smasimore/EnvironmentalControlSystem/Documentation/ECSBOM.xlsx

 | Component | Subsystem | Purpose | Quantity | PCB REF DES | PCB Package | Manufacturer | Mfg. P/N | Distributor | P/N | Unit Cost ($) | Cost ($) | Included in $40 Constraint | Where To Get | Datasheet
Electrical | Air Quality Click Sensor | Controller | CO2 Sensor | 1 | U4 | user | MikroElektronika | MIKROE-1630 | Digikey | 1471-1358-ND | 16.83 | 16.83 | TRUE | Order Online | http://download.mikroe.com/documents/add-on-boards/click/air-quality/air-quality-click-manual-v100.pdf
 | TM4C123GH6PM 64-pin LQFP | Controller | CPU | 1 | U1 | LQFP | TI | TM4C123GH6PMI | Mouser | 595-TM4C123GH6PMI | 11.55 | 11.55 | FALSE | PCB | http://www.ti.com/lit/ds/symlink/tm4c123gh6pm.pdf
 | 18-bit color 128*160 1.8" TFT LCD display | Controller | LCD | 1 | J4 | LCD | Sitronix | ST7735R | Adafruit | 358 | $19.96 | 19.96 | FALSE | Order Online | https://www.crystalfontz.com/controllers/ST7735/
 | 8-Ohm Speaker | Controller | Speaker | 1 | J2 | DIP | PUI Audio | AS03208MS-3-R | Mouser | 665-AS03208MS-3-R | 8.97 | 8.97 | FALSE | Cabinet
 | Power Header | Controller | Power | 1 | J8 | SIP |  |  |  |  | 0.10 | 0.10 | FALSE | Cabinet
 | Crystal | Controller | Processing | 1 | Y1 | NX5032 | NDK | NX5032GA-16.000000 | Digikey | 644-1037-1-ND | 0.51 | 0.51 | FALSE | PCB
 | JTAG 1 by 5 Male Header | Controller | JTAG | 1 | J1 | SPI | Molex | 90120-0125 | Mouser | 538-90120-0125 | 0.29 | 0.29 | FALSE | Cabinet
 | Logic Analyzer Connector | Controller | Logic Analyzer | 3 | J3 J6 J7 | DIP | FCI | 68021-208HLF | Digikey | 609-3344-ND | 0.27 | 0.81 | FALSE | Cabinet
 | Rectifier | Controller | Electrolysis | 1 | rectifier | USER |  |  |  |  | 2.00 | 2.00 | TRUE | Order Online
 | IRF540 MOSFET N-channel, TO220 | Controller | Electrolysis | 1 | Q1 | DSC | Fairchild | IRF540 | Digikey | IRF540NPBF-ND | 1.95 | 1.95 | FALSE | McDermott | https://media.digikey.com/pdf/Data%20Sheets/ST%20Microelectronics%20PDFS/IRF540.pdf
 | LP2950 3.3V regulator, 100 mA TO-92 | Controller | Regulator | 1 | U2 | TO220 | TI | LP2950-33LPRE3 | Digikey | 296-31455-1-ND | 0.19 | 0.19 | FALSE | Cabinet
 | Tactile Switch, surface mount | Controller | UI | 3 | SW3 SW4 SW5 | SW | C&K Components | KSC353JLFG | Mouser | 611-KSC353JLFG | 0.86 | 2.58 | FALSE | Cabinet
 | On/off power switch | Controller | Power Switch | 1 | SW2 | DIP |  |  | BGMicro | SWT1010 | 0.85 | 0.85 | FALSE | Cabinet
 | Tactile Switch, surface mount | Controller | TM4C Reset | 1 | SM | SW1 | C&K Components | KSC353JLFG | Mouser | 611-KSC353JLFG | 0.86 | 0.86 | FALSE | Cabinet
 | Ceramic, X7R, 20%, 1 uF | Controller | TM4C | 5 | C7 C11 | CAP |  |  | Jameco | $81509.00 | 0.35 | 1.75 | FALSE | Cabinet
 | Ceramic, Z5U, -20/+80%, 0.1 uF | Controller | TM4C | 4 | C4 C6 C10 C9 C17 | CAP |  |  | Digikey | 399-4151-ND | 0.05 | 0.20 | FALSE | Cabinet
 | Ceramic, Z5U, -20/+80%, 0.01 uF | Controller | TM4C | 3 | C8 C3 C5 | CAP |  |  | Digikey | 399-4148-ND | 0.40 | 1.20 | FALSE | Cabinet
 | Ceramic C0G, 10%, 10 pF | Controller | TM4C | 2 | C13 C14 | CAP | Murata 50V 5% | RDE5C1H100J0P1H03B | Digikey | 490-8629-ND | 0.31 | 0.62 | FALSE | Cabinet
 | Tantalum, 16V, 20% 2.2 uF | Controller | TM4C | 1 | C12 | CAP-Tant | AVX Corporation | TAP225M016CCS | Mouser | 581-TAP225M016CCS | 0.29 | 0.29 | FALSE | Cabinet
 | Tantalum, 16V, 10% 4.7 uF | Controller | Power Regulator | 2 | C2 C1 C16 | CAP-Tant |  |  | Jameco | $94035.00 | 0.22 | 0.44 | FALSE | Cabinet
 | 18-bit color 128*160 1.8" TFT LCD display | UI | LCD | 1 | J4 | LCD | Sitronix | ST7735R | Adafruit | 358 | 19.96 | 19.96 | FALSE | Order Online | https://cdn-shop.adafruit.com/datasheets/ST7735R_V0.2.pdf
 | LED Red 1.6V 1mA 5mm diffused | UI / Controller | LED | 2 | D1 D2 | SIP | Avago Technologies | HLMP-D150 | Digikey | 516-1323-ND | 0.29 | 0.58 | FALSE | Cabinet
 | LED Yellow 2mA 5mm diffused | UI | LED | 1 | D3 | SIP | Avago Technologies | HLMP-4719 | Digikey | 516-1326-ND | 0.29 | 0.29 | FALSE | Cabinet
 | LED Green 2mA 5mm diffused | UI | LED | 1 | D4 | SIP | Avago Technologies | HLMP-4740 | Digikey | 516-1327-ND | 0.29 | 0.29 | FALSE | Cabinet
 | B3F Tactile Push Button Switch | UI | Switches | 3 |  |  | Omron Electronics | B3F-1052 | Digikey | SW405-ND | 0.17 | 0.51 | FALSE | Cabinet
 | PN2222 NPN Transistor | UI | Speaker | 1 | TO92 | Q2 | Fairchild | PN2222 | Digikey | PN2222BU-ND | 0.13 | 0.13 | FALSE | Cabinet
 | 1N914 Diode | UI | Speaker | 1 | D3 | MISC | Fairchild | 1N914 | Digikey | 1N914B-ND | 0.05 | 0.05 | FALSE | Cabinet
 | Carbon 1/6W, 5%, 10k Resistor | UI / Controller | Switches and Resart Switch | 6 | R2 R4 R5 R6 | DIP | Yageo | CFR-25JR-52-2K2 | Digikey | 2.2KQTR-ND | 0.01 | 0.06 | FALSE | Cabinet
 | Carbon 1/6W, 5%, 2.2k Resistor | UI | Speaker | 1 | R7 | DIP | Stackpole Electronics Inc. | CF18JT2K20 | Digikey | CF18JT2K20TR-ND | 0.01 | 0.01 | FALSE | Cabinet
 | Carbon 1/6W, 5%, 1M Resistor | Controller | TM4C | 1 | R1 | DIL | Stackpole Electronics Inc. | CF18JT1M00 | Digikey | CF18JT1M00TR-ND | 0.01 | 0.01 | FALSE | Cabinet
 | Carbon 1/6W, 5%, 470 Resistor | Controller | Micro USB, LED's | 1 | R3 R8 R9 R10 | DIL | Stackpole Electronics Inc. | CF18JT470R | Digikey | CF18JT470RTR-ND | 0.01 | 0.01 | FALSE | Cabinet
 | Test Point, Black | Controller | Electrolysis and Micro USB | 6 | TP1 TP2 TP3 TP4 GND GND3 | BIG / DIL | Keystone Electronics | 5001 | Digikey | 36-5001K-ND | 0.23 | 1.38 | FALSE | Cabinet
 | USB to Micro USB Cable | Controller | Power | 1 |  |  | Qualtek | 3025010-03 | Digikey | Q853-ND | 2.31 | 2.31 | FALSE | Order Online
 | 1' Wires | Controller | To Sensor | 6 |  |  |  |  |  |  | 0.01 | 0.06 | TRUE | Order Online
 | Alligator Clip Wire | Electrolysis | Power to Electrodes | 2 |  |  | SE | TL10 | Amazon | B0002KRABU | 0.59 | 1.18 | TRUE | Order Online
 | 4mm x 100mm Carbon Electrode | Electrolysis | Provide V and I to solution | 2 |  |  | Frey Scientific | 576672 | Amazon | B00FGDRA8G | 1.60 | 3.20 | TRUE | Order Online
 | 5.5" x 5.5" x 1" Box | Controller | Enclosure | 1 |  |  |  |  |  |  | 0.00 | 0.00 | FALSE | PRINT
Mechanical / Chemical | 1.18L Medium Square Ziploc Container and Lid | Electrolysis | Enclosure | 1 |  |  | Ziploc | N/A | HEB | N/A | 0.86 | 0.86 | TRUE | In Store
 | Distilled H2O | Electrolysis | Reactant and Conductor | 1 |  |  | HEB | N/A | HEB | N/A | 0.99 | 0.99 | TRUE | In Store
 | Sodium Bicarbonate | Electrolysis | Increase Solution Conductivity | 1 |  |  | Arm & Hammer | N/A | HEB | N/A | 1.19 | 1.19 | TRUE | In Store
 | 1" ID x 1 1/4" OD x 1/8" Wall 4"L | Electrolysis | H2 Capture | 1 |  |  | Small Parts | TPC-125/20 | Amazon | B000OMJ578 | 1.41 | 1.41 | TRUE | Order Online
 | Plastic Bags | Electrolysis | H2 Capture | 2 |  |  |  |  |  |  |  |  | TRUE | In Store
 | Rubber band | Electrolysis | H2 Capture | 2 |  |  |  |  |  |  |  |  | TRUE | In Store
 | 4mm Hole Tapered Stopper 9mm-14mm | Electrolysis | Hold Electrodes | 6 |  |  | uxcell | a14120400ux0371 | Amazon | B00XBG6DO2 | 0.65 | 3.90 | TRUE | Order Online
 | A" x B" x C" Box | Environment | Enclosure | 1 |  |  |  |  |  |  | 0.00 | 0.00 | FALSE | Print
 | 1/4" ID x 3/8" OD 1'L | Environment | Transport O2 and CO2 to Environment | 2 |  |  | Vinyl-Flex | PVC14-38ANA | Amazon | B00E6BD0G0 | 0.16 | 0.32 | TRUE | Order Online
 | 1/4", .5 PSI Polypropylene Standard Check Valve with Viton® Diaphragm | Environment | 1-Way Flow of O2, CO2, and Pressure Release | 3 |  |  | Ark-Plas | HAX24-PPO | US Plastics | 64048 | 0.75 | 2.25 | TRUE | Order Online
 |  |  |  |  |  |  |  |  |  |  | Total Cost (all) | 112.90
 |  |  |  |  |  |  |  |  |  |  | Total Cost (minus excluded) | 34.19
