smasimore/EnvironmentalControlSystem/(list of files, drawings)

Other design files:
Documentation/ECSPCB.pcb
