smasimore/EnvironmentalControlSystem/CO2Sensor.c

/********** CO2Sensor.c ************** 
 Name: Sarah Masimore (sm66498) and Sam Harper (slh3927)
 Lab Number: Officially 16415, in reality MW 9-10:30am
 TA: Andrew Lynch  
 Created Date: 10/29/2017
 Last Updated Date: 11/14/2017
 Description: API for initializing and sampling CO2 sensor. Uses PE5, ADC0, and 
  Timer1A. Modified from ValvanoWare.
 Hardware: 
    TM4C123G LaunchPad 
    MQ-135 CO2 Sensor  
 Hardware Configuration: 
   See schematic.
 */

#include <stdint.h>
#include "tm4c123gh6pm.h"
#include "CO2Sensor.h"
#include "ECSMain.h"

#define ADC_AVGING 6
#define SENSOR_OFFSET 230
#define SENSOR_MAX 999
#define SENSOR_MIN 0

static void testWait(void);

/**************CO2Sensor_Init***************
 Description: Inits PE5, ADC0, and Timer1A.
 Inputs: none
 Outputs: none
*/
void CO2Sensor_Init() {
  initPortAndADC();
  initTimer1A();
}

/**************CO2Sensor_Init***************
 Description: Converts ADC value to % CO2. Used 2 calibration points, air ~0%
    and exhaled air ~5%. Voltage scales linearly and with appropriate slope,
    but ~0 CO2 (Austin air) has voltage ~1555, so using offset for calibration.
 Inputs: none
 Outputs: Int between 0 and 999 representing 00.0% to 99.9% CO2 in the air.
*/
int CO2Sensor_ADCToPercCO2(int adcVal) {  
  int perc = adcVal * 1000 / 4096 - SENSOR_OFFSET;

  if (perc > SENSOR_MAX) {
    return SENSOR_MAX;
  } else if (perc < SENSOR_MIN) {
    return SENSOR_MIN;
  }
  
  return perc;
}

// PRIVATE FUNCTIONS

/**************initPortAndADC***************
 Description: Inits PE5 and ADC0.
 Inputs: none
 Outputs: none
*/
void initPortAndADC() {
  SYSCTL_RCGCADC_R |= 0x0001; // Activate ADC0 
  SYSCTL_RCGCGPIO_R |= 0x10; // Activate clock for Port E
  while((SYSCTL_PRGPIO_R&0x10) != 0x10){};
  GPIO_PORTE_DIR_R &= ~0x20; // Make PE5 input
  GPIO_PORTE_AFSEL_R |= 0x20; // Enable alternate function on PE5
  GPIO_PORTE_DEN_R &= ~0x20; // Disable digital I/O on PE5
  GPIO_PORTE_AMSEL_R |= 0x20; // Enable analog functionality on PE5

  ADC0_PC_R &= ~0xF; // Clear max sample rate field
  ADC0_PC_R |= 0x1; // Configure for 125K samples/sec
  ADC0_SSPRI_R = 0x0123; // Sequencer 3 is highest priority
  ADC0_ACTSS_R &= ~0x0008; // Disable sample sequencer 3
  ADC0_EMUX_R &= ~0xF000; // Seq3 is software trigger
  ADC0_SSMUX3_R &= ~0x000F; // Clear SS3 field
  ADC0_SSMUX3_R += 8; // Set channel
  ADC0_SSCTL3_R = 0x0006; // No TS0 D0, yes IE0 END0
  ADC0_IM_R &= ~0x0008; // Disable SS3 interrupts
  ADC0_ACTSS_R |= 0x0008; // Enable sample sequencer 3
    
  ADC0_SAC_R = ADC_AVGING;
  
  // Init value
  ECSMain_CO2ADCVal = getADCVal();
  ECSMain_CO2Val = CO2Sensor_ADCToPercCO2(ECSMain_CO2ADCVal);
}

/**************initTimer1A***************
 Description: Inits Timer1A. Interrupts every 50ms.
 Inputs: none
 Outputs: none
*/
void initTimer1A() {
  SYSCTL_RCGCTIMER_R |= 0x02; // Activate TIMER1 (bit 1)
  while((SYSCTL_RCGCTIMER_R & 0x00000002) == 0){}; // Wait until Timer1 is clocked
  TIMER1_CTL_R = 0; // Disable TIMER1A during setup
  TIMER1_CFG_R = 0; // Configure for 32-bit mode
  TIMER1_TAMR_R = 0x2; // Configure for periodic mode, default down-count settings
  TIMER1_TAILR_R = 8000000-1; // Reload value (100ms)
  TIMER1_TAPR_R = 0; // Bus clock resolution
  TIMER1_ICR_R = 0x1; // Clear TIMER1A timeout flag
  TIMER1_IMR_R = 0x1; // Arm timeout interrupt
  NVIC_PRI5_R = (NVIC_PRI5_R&0xFFFF00FF)|0x00006000; // Priority 3
  NVIC_EN0_R |= 1<<21; // Enable IRQ 21 in NVIC
  TIMER1_CTL_R = 0x00000001;
}

/**************Timer1A_Handler***************
 Description: Handles Timer1A interrupt. Gets ADC value and stores in ECSMain
  global variable.
 Inputs: none
 Outputs: none
*/
void Timer1A_Handler() {
  TIMER1_ICR_R = TIMER_ICR_TATOCINT; // Acknowledge
  ECSMain_CO2ADCVal = getADCVal();
}

/**************getADCVal***************
 Description: Gets ADC value from ADC0.
  global variable.
 Inputs: none
 Outputs: int ADC value
*/
int getADCVal() {
  int adcVal;
  ADC0_PSSI_R = 0x0008; // Initiate SS3
  while((ADC0_RIS_R&0x08)==0){}; // Wait for conversion done
  adcVal = ADC0_SSFIFO3_R&0xFFF; // Read result
  ADC0_ISC_R = 0x0008; // Acknowledge completion

  return adcVal;
}

// TEST FUNCTIONS

/**************CO2Sensor_Test***************
 Description: Gets ADC value, waits, and repeats.
  global variable.
 Inputs: none
 Outputs: none
*/
void CO2Sensor_Test() {
  initPortAndADC();
  
  while (1) {
    getADCVal();
    testWait();
  }
}

/**************testWait***************
 Description: Helper function to wait between test cases.
 Inputs: none
 Outputs: none
*/
static void testWait() {
  for(int j = 0; j < 80000000; j++) {};
}
