smasimore/EnvironmentalControlSystem/ECSMain.h

/********** ECSMain.h ************** 
 Name: Sarah Masimore (sm66498) and Sam Harper (slh3927)
 Lab Number: Officially 16415, in reality MW 9-10:30am
 TA: Andrew Lynch  
 Created Date: 10/29/2017
 Last Updated Date: 11/14/2017
 Description: Main controller for ECS. Initializes modules and transitions
    system between states. Test mode managed through TestMode variable to
    test each module independently.
 Hardware: 
    See schematic.
 Hardware Configuration: 
   See schematic.
 */

// GLOBAL VARIABLES

// Struct type to contain attributes of the 3 ECS states.
typedef struct ECSState_t {
  enum led {LED_GREEN, LED_YELLOW, LED_RED} led;
  enum sound {SOUND_OFF, SOUND_ON} sound;
  enum electrolysis {ELEC_OFF, ELEC_ON} electrolysis;
} ECSState_t;

// EM_NONE: Not currently editing anything
// EM_SOFT_LIMIT: Editing soft limit
// EM_HARD_LIMIT: Editing hard limit
typedef enum EditMode_t {EM_NONE, EM_SOFT_LIMIT, EM_HARD_LIMIT} EditMode_t;
extern EditMode_t ECSMain_EditMode;

extern const ECSState_t * ECSMain_State;
extern int ECSMain_CO2ADCVal; // 0 - 4095
extern int ECSMain_SoftLimit; // 0 - 999, resolution of .1
extern int ECSMain_HardLimit; // 0 - 999, resolution of .1
extern int ECSMain_CO2Val; // 0 - 999, resolution of .1
extern int ECSMain_PrevCO2ADCVal;
extern int ECSMain_PrevCO2Val;
extern int ECSMain_PrevSoftLimit;
extern int ECSMain_PrevHardLimit;
extern int ECSMain_PrevEditMode;
