smasimore/EnvironmentalControlSystem/(commit log)

2017-11-14 Revert "lab 9 prep"
    This reverts commit 60fd8d5a48ed83a83174e03ff84c39d5fba64e28.
    [CO2Sensor.c, CO2Sensor.h, ECSMain.c, ECSMain.h, Electrolysis.c, Electrolysis.h, LCD.c, LCD.h]
2017-12-05 calibrate CO2 sensor
2017-12-08 Add documentation folder
    [ECSBOM.xlsx, ECSPCB.pcb, ECSSchematic.sch]
